ridephysics/hardware/imulogger/imulogger.kicad_pcb

## KiCad design imulogger/imulogger.kicad_pcb (2019-05-21)

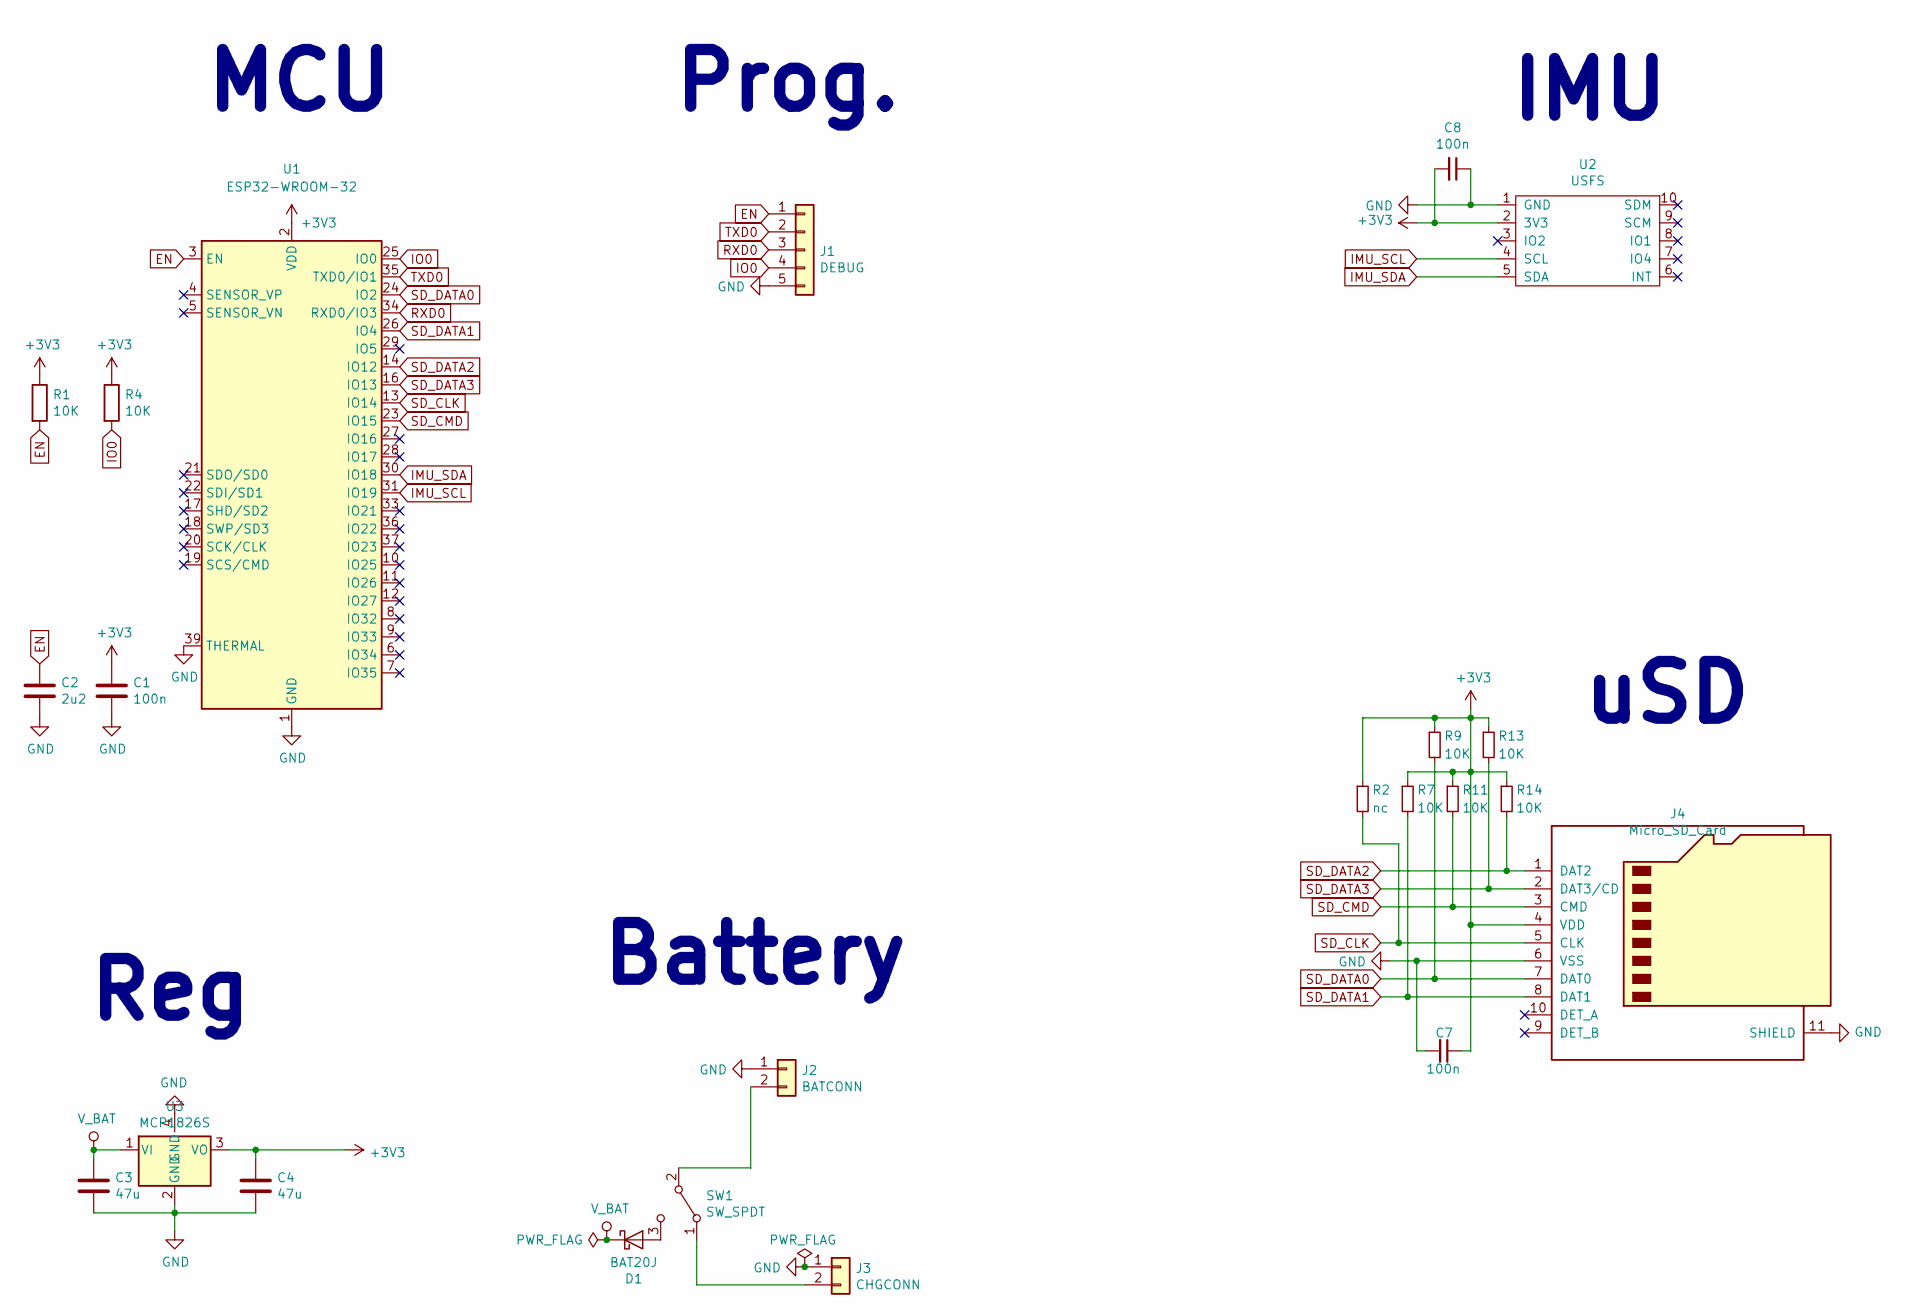
[picture p1: schematic imulogger.sch]

Parts:
C1, C7, C8: 100n; C_0805_2012Metric_Pad1.15x1.40mm_HandSolder
C2: 2u2; C_0805_2012Metric_Pad1.15x1.40mm_HandSolder
C3, C4: 47u; C_0805_2012Metric_Pad1.15x1.40mm_HandSolder
D1: BAT20J; D_SOD-323
J1: DEBUG; PinHeader_1x05_P2.54mm_Vertical
J2: BATCONN; PinHeader_1x02_P2.54mm_Vertical
J3: CHGCONN; JST_PH_S2B-PH-K_1x02_P2.00mm_Horizontal
J4: Micro_SD_Card; microSD_HC_Hirose_DM3D-SF
R1, R4, R7, R9, R11, R13, R14: 10K; R_0805_2012Metric_Pad1.15x1.40mm_HandSolder
R2: nc; R_0805_2012Metric_Pad1.15x1.40mm_HandSolder
SW1: SW_SPDT; SK-3296S-01-L3
U1: ESP32-WROOM-32
U2: USFS
U3: MCP1826S; SOT-223

Connections:
+3V3: C1.1, C4.1, C7.1, C8.2, J4.4 (VDD), R1.1, R2.1, R4.1, R7.1, R9.1, R11.1, R13.1, R14.1, U1.2 (VDD), U2.2 (3V3), U3.3 (VO)
EN: C2.1, J1.1, R1.2, U1.3 (EN)
GND: C1.2, C2.2, C3.2, C4.2, C7.2, C8.1, J1.5, J2.1, J3.1, J4.6 (VSS), J4.11 (SHIELD), U1.1 (GND), U1.15 (GND), U1.38 (GND), U1.39 (THERMAL), U2.1 (GND), U3.2 (GND), U3.4 (GND)
IMU_SCL: U1.31 (IO19), U2.4 (SCL)
IMU_SDA: U1.30 (IO18), U2.5 (SDA)
IO0: J1.4, R4.2, U1.25 (IO0)
unnamed: D1.2 (A), SW1.3 (C)
unnamed: J2.2, SW1.2 (B)
unnamed: J3.2, SW1.1 (A)
RXD0: J1.3, U1.34 (RXD0/IO3)
SD_CLK: J4.5 (CLK), R2.2, U1.13 (IO14)
SD_CMD: J4.3 (CMD), R11.2, U1.23 (IO15)
SD_DATA0: J4.7 (DAT0), R9.2, U1.24 (IO2)
SD_DATA1: J4.8 (DAT1), R7.2, U1.26 (IO4)
SD_DATA2: J4.1 (DAT2), R14.2, U1.14 (IO12)
SD_DATA3: J4.2 (DAT3/CD), R13.2, U1.16 (IO13)
TXD0: J1.2, U1.35 (TXD0/IO1)
V_BAT: C3.1, D1.1 (K), U3.1 (VI)

Notes on the sheet:
MCU
uSD
IMU
Prog.
Reg
Battery

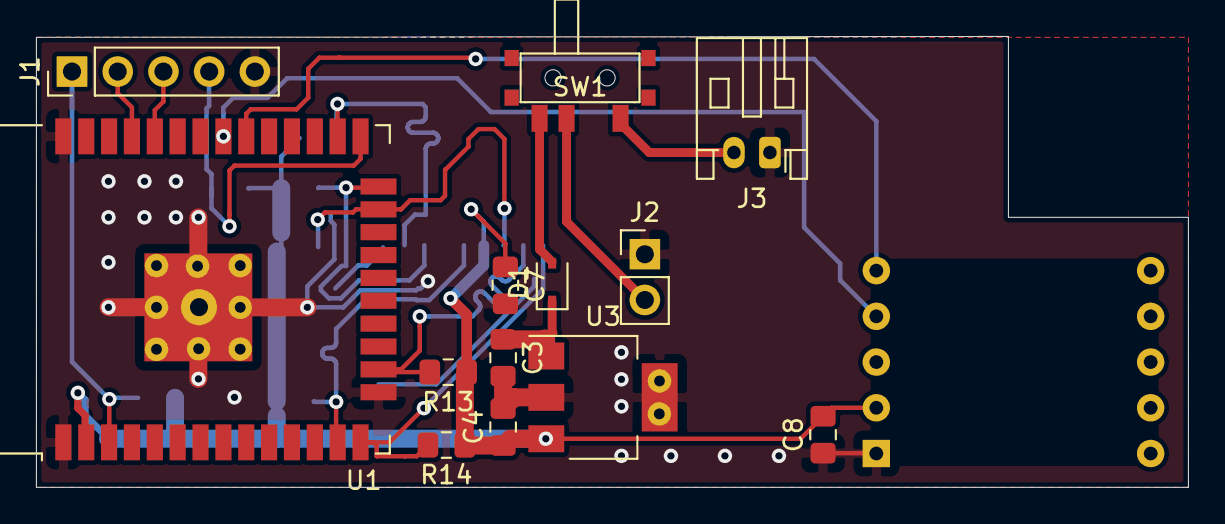
[picture p2: board imulogger.kicad_pcb from above]

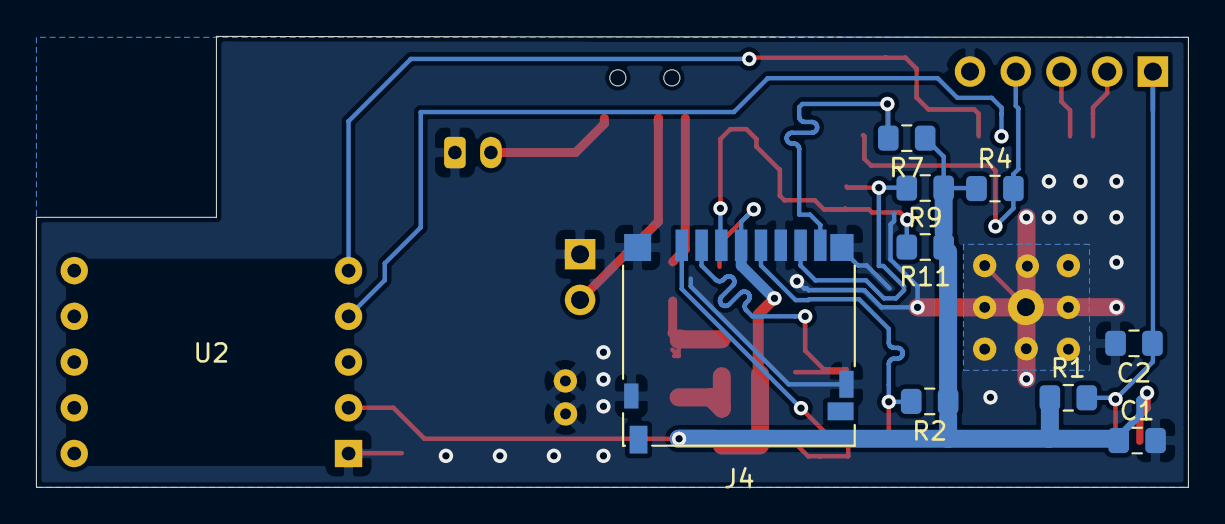
[picture p3: board imulogger.kicad_pcb from below]

Board: 2 copper layers, 64.0 x 25.0 mm, 23 parts (10 on the bottom side), 18 nets.
