ridephysics/hardware/(commit log)

2019-04-17 Initial version
    [imulogger.kicad_pcb, imulogger.sch]
2019-04-18 Revert "experiment"
    This reverts commit 6fe68751296b879cc60505c4876b2cc8c070c93c.
    [imulogger.kicad_pcb, imulogger.sch]
2019-04-18 imulogger simply schematic
    [imulogger.sch]
2019-04-18 imulogger: use 47K pull-ups for sdcard
    [imulogger.sch]
2019-04-18 imulogger: use 0805 footprints for LDO capacitors
    [imulogger.sch]
2019-04-18 imulogger: use copy of ESP32 which adds a thermal pin
    [imulogger.sch]
2019-04-18 imulogger: create copy of esp32 footprint with thermal pad modifications
    this was inspired by the one from olimex
2019-04-18 imulogger: use our custom esp32 footprint
    [imulogger.sch]
2019-04-20 redesign power supply
    - add battery and charger
    - use LDO with a proper dropout voltage
    [imulogger.kicad_pcb, imulogger.sch]
2019-04-20 Revert "imulogger: use 47K pull-ups for sdcard"
    This reverts commit df5adce347d57e44a57313ac28780a91eea5d007.
    10K is the value recommended by espressif and it's closer to olimex' 2.2k
    [imulogger.sch]
2019-04-21 imulogger/imulogger-symbols: rename custom power source pins
    otherwise they're all connected to each other
2019-04-21 imulogger: create custom SOT-223 footprint with heat pad optimizations
2019-04-21 imulogger: assign footprints
    [imulogger.sch]
2019-04-22 use correct pin numbers for thermal holes
2019-04-22 new pcb layout
    [imulogger.kicad_pcb, imulogger.sch]
2019-04-22 pcb optimizations
    [imulogger.kicad_pcb]
2019-04-22 pcb: remove excessive vias close to the IMU
    [imulogger.kicad_pcb]
2019-05-12 imulogger: pcb: reroute i2c and optimize ground fillings
    [imulogger.kicad_pcb]
2019-05-18 imulogger: add battery protection circuit
    [imulogger.kicad_pcb, imulogger.sch]
2019-05-18 imulogger: put connectors on the component side and remove useless track
    [imulogger.kicad_pcb]
2019-05-20 imulogger: add SK-3296S-01-L3 footprint
2019-05-20 remove charger and add switch and JST socket
    [imulogger.kicad_pcb, imulogger.sch]
2019-05-20 remove battery protection circuit
    my battery has that already and even if I had one without one
    it'd be easier to buy one and glue it to the battery than soldering
    these small ICs.
    [imulogger.kicad_pcb, imulogger.sch]
2019-05-20 remove 3d model from battery connector
    I'll solder cables instead of using pin headers
    [imulogger.kicad_pcb]
2019-05-20 make switch route V_BAT instead of GND
    even though it shouldn't make a difference it's probably better to
    not connect the system load to the charger.
    [imulogger.kicad_pcb, imulogger.sch]
2019-05-20 optimize ground connection
    [imulogger.kicad_pcb]
2019-05-21 properly separate i2c and sd using ground plane
    unfortunately I had to remove the 3V3 pin to achieve this
    [imulogger.kicad_pcb, imulogger.sch]
2019-05-21 changes caused by producing gerber and drill files
    [imulogger.kicad_pcb]
